C-Elegans/CounterDSP/README.org

* uFluidics Counter Project
This repository is the code for the EE4400 uFluidics Counting Project,
for the dsPIC33fj128gp802. To build, make sure MPLAB X and XC16 are
installed, then run 'make'.

** Circuit
   - Chip: dsPIC33fj128gp802 - dip variant
   - ADC connection
     - Pin AN9, package pin 28
   - SPI:
     - SCK: RP12, pin 23
     - MOSI: RP11, pin 22
     - MISO: RP13, pin 24
     - SS_N: RP14, pin 25
   - Passives:
     - 100nF caps: pin 28, pin 20, pin 13
     - 10uF cap: pin 20
       - *This component is REQUIRED to program the chip*
     - 1k pullup on MCLR_N (pin 1)
   - Supply Voltage
     - 3.25V

** Specifications
   - Analog input signal 200mv pk, unknown waveform
   - Amplified to some level 700mv pk?
   - Sampled at 10kHz
   - Cells counted somehow

# ** DONE List [100%]
#    CLOSED: [2018-03-24 Sat 14:36]
#    - [X] Test the features of the chip [100%]
#      - [X] ADC
#      - [X] UART
#      - [X] SPI
#      - [X] DMA [2/2]
#        - [X] UART
#        - [X] ADC
#      - [X] 80MHz Clock
#      - [X] 10kHz timer
#    - [X] Create A mini oscilloscope
#    - [X] Collect simulated waveform
#      - Waveforms are in data/
#    - [X] Analyze simulated data in matlab, determine best counting method
#      - [X] FFT amplitude
#      - [X] Correlation + threshold
#        - [X] Correlation
#        - [X] Create better correlation waveform. Currently just a sine wave, but
# 	     needs to approximate the triangle-y shape of the actual signal
#        - [X] Proper threshold amount
#    - [X] Program above solution on dsp
#      - Collect 256 samples from ADC
#      - Append them to previous 256 samples
#      - Convert samples to complex, pad with 0s to go to 1024 samples
#      - Run FFT
#      - multiply with FFT of the target waveform (stored in program memory)
#      - run IFFT
#      - Threshold + count
     
** Version 0.2 TODO [0%]
   - [ ] Add display [0%]
     - [ ] Choose display
     - [ ] Find/Write library
     - [ ] Write display routine
   - [ ] Increase number of channels
     - Goal of 3
   - [ ] Reduce memory usage per channel [0%]
     - [ ] Eliminate ping pong buffer
     - [ ] Copy unused data to X memory
     - [ ] Reduce sample storage [0/3]
       - [ ] Do unbatched correlation + threshold
       - [ ] Reduce size of buffers
       - [ ] Reduce sample rate
   - [ ] Design PCB

** Collected data
#+attr_html: :width 500px
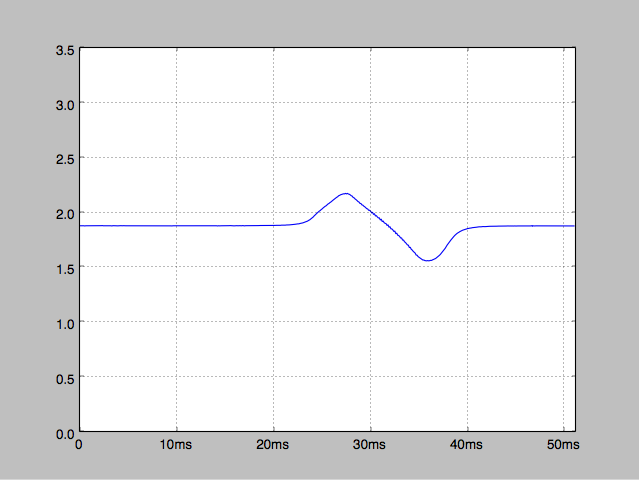
[picture p1: data/data2.png]


A large nail dropped through a straw, sampled at 5kHz
#+attr_html: :width 500px
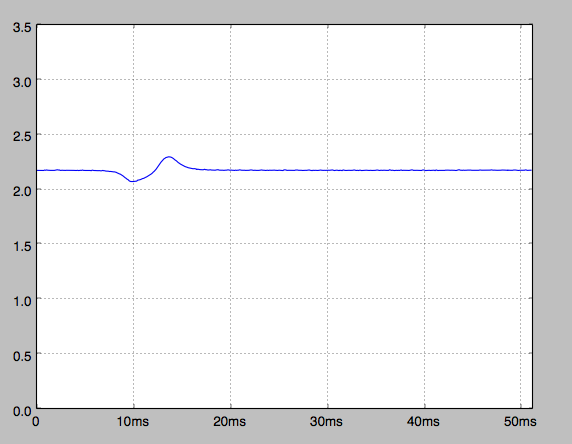
[picture p2: data/data4.png]


A small piece of nail dropped through a straw, 5kHz

* Characterization
** With Two cubic magnets
   - 58mV output from coil
   - 30 turns around straw
   - Straw
     - 5.3mm diameter
     - 
   - ??T field strength
     - Can calculate
     - Measure with hall effect sensor

* Amplifier
** Specifications
   - needs gain of 400mV/600nV=660,000
   - Uses AD8428 as low noise input amplifier (g=2000)
   - Uses ADa4528 as final amplifier
     - Feedback resistors set for g=330, Rf=33k, Rg=100\Omega
   - +- 5V power supply
     - May need to do some scaling with a third amp to feed to DSP
** Simulation
   - Outputs 300mV pk/pk for 300nVpk/pk input
   - 1/f Noise at 50mV
#+attr_html: :width 500px
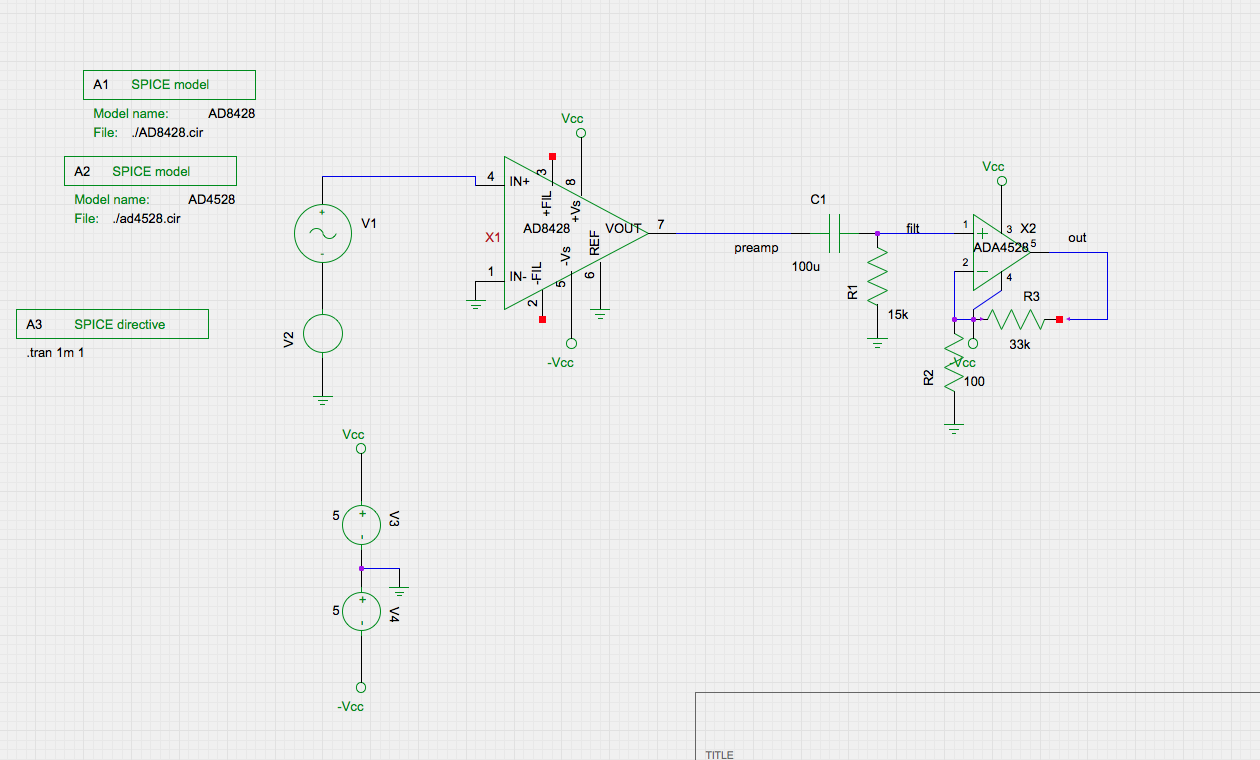
[picture p3: photos/schematic.png]

#+attr_html: :width 500px
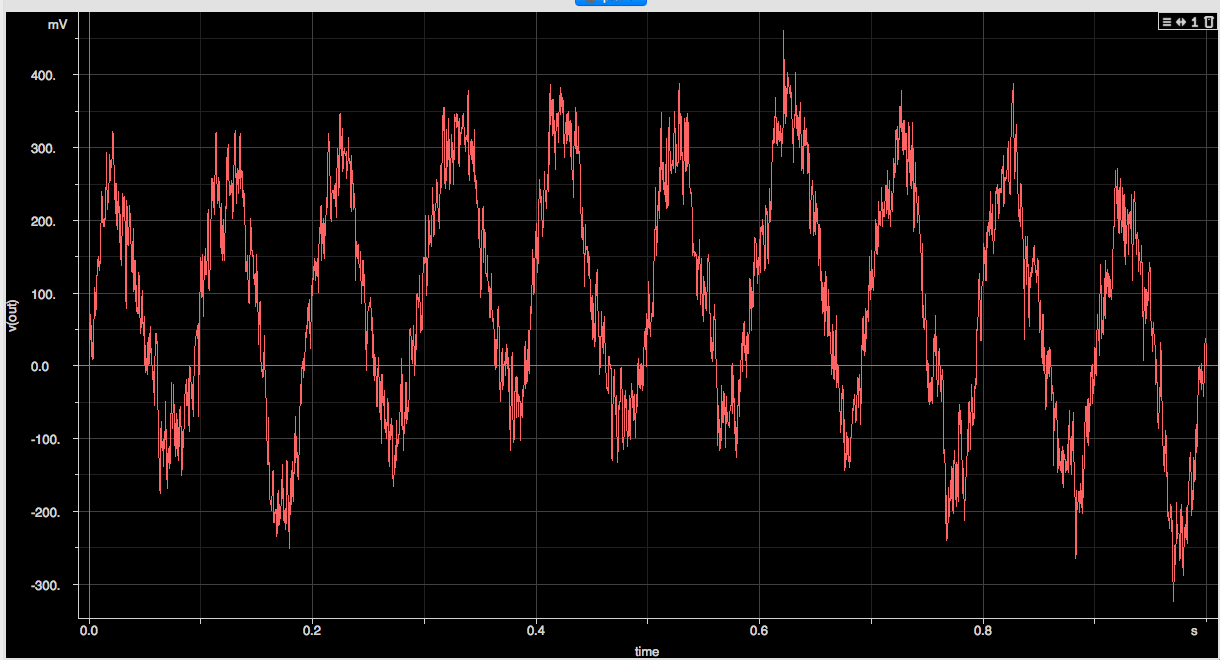
[picture p4: photos/amp1.png]
