C-Elegans/CounterDSP/circuit/schematic.png

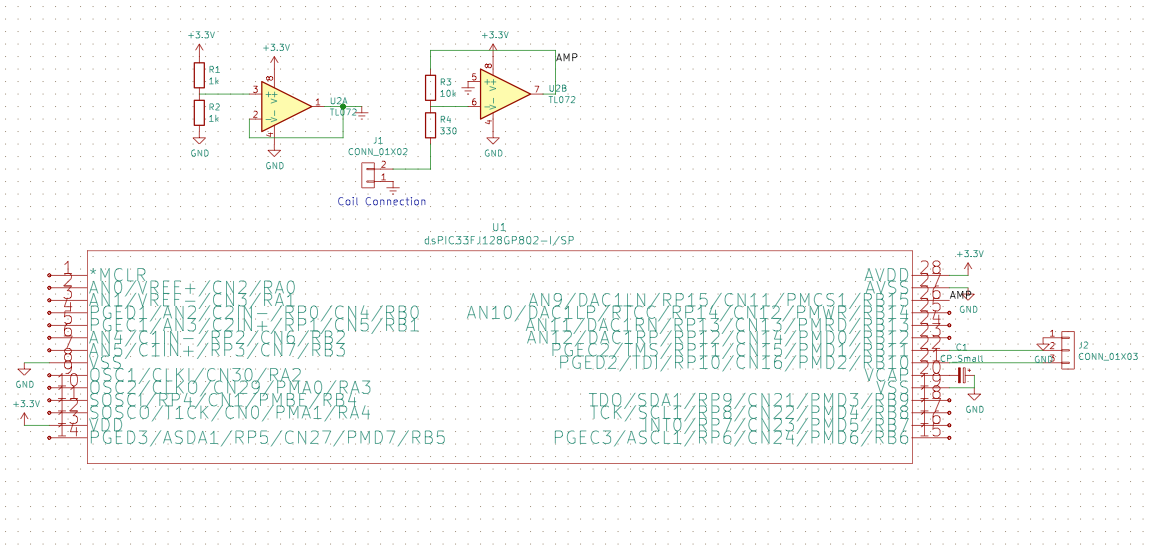
circuit/schematic.png
