C-Elegans/CounterDSP/data/data1.png

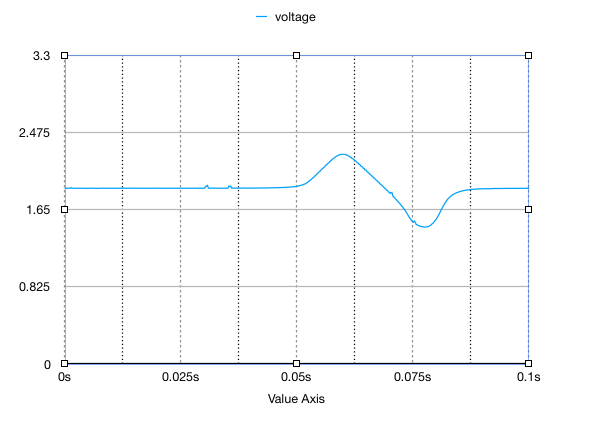
data/data1.png
