C-Elegans/CounterDSP/photos/ampv2_noise.png

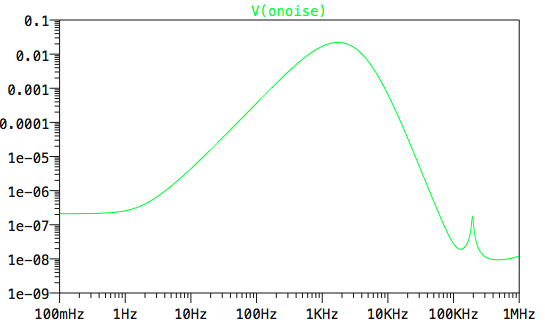
photos/ampv2_noise.png
