C-Elegans/CounterDSP/photos/ampv2_signal.png

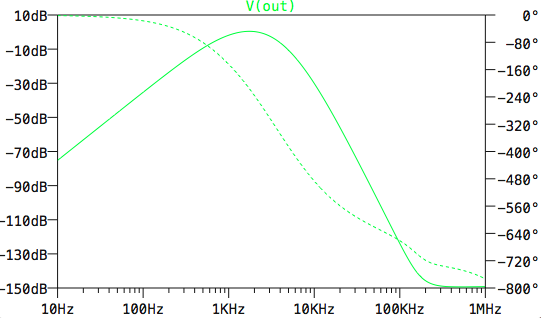
photos/ampv2_signal.png
