C-Elegans/CounterDSP/newamp/sim/ampv2.asc

C1: cap; 100n
C2: cap; 5n
C3: cap; 100n
C4: cap; 5n
C5: cap; 31n
C6: cap; 31n
C7: cap; 500n
C8: cap; 31n
L1: ind; 150n
R1: res; 10k
R2: res; 100
R3: res; 100
R4: res; 100
R5: res; 2k
R6: res; 15k
R7: res; 1k
R8: res; 1k
R9: res; 100
R10: res; 1k
R11: res; 100
R12: res; 1k
R13: res; 100
R14: res; 1k
R15: res; 1k
R16: res; 2k
U1: AD8428
U2: AD8428
U3: ADA4528
U4: ADA4528
U5: ADA4528
U6: ADA4528
U7: ADA4528
V1: voltage; 4
V2: voltage; 4
V3: voltage; SINE(0 100n 3k); AC 100n
Named nets: v-, v+, 0, in+, in-, fil+, fil-, pre, a, b, vref, out
;.tran 10u 5m
;.ac oct 50 10 1Meg
.noise v(out) v3 oct 100 0.1 1Meg
;.op
.temp -70
