C-Elegans/CounterDSP/newamp/sim/Draft1.asc

C3: cap; 100n
C4: cap; 1n
R5: res; 1.5k
R6: res; 15k
R7: res; 1k
R8: res; 1k
R9: res; 100
R10: res; 100k
U1: AD8428
U2: AD8428
U3: ADA4528
U4: ADA4528
V1: voltage; 4
V2: voltage; 4
V3: voltage; SINE(0 100n 3k); AC 100n
Named nets: v-, v+, 0, in+, in-, fil+, fil-, pre, vref, out
.ac oct 10 10 1Meg
