C-Elegans/CounterDSP/newamp/nVamp.kicad_pcb

## KiCad design newamp/nVamp.kicad_pcb (2018-12-07)

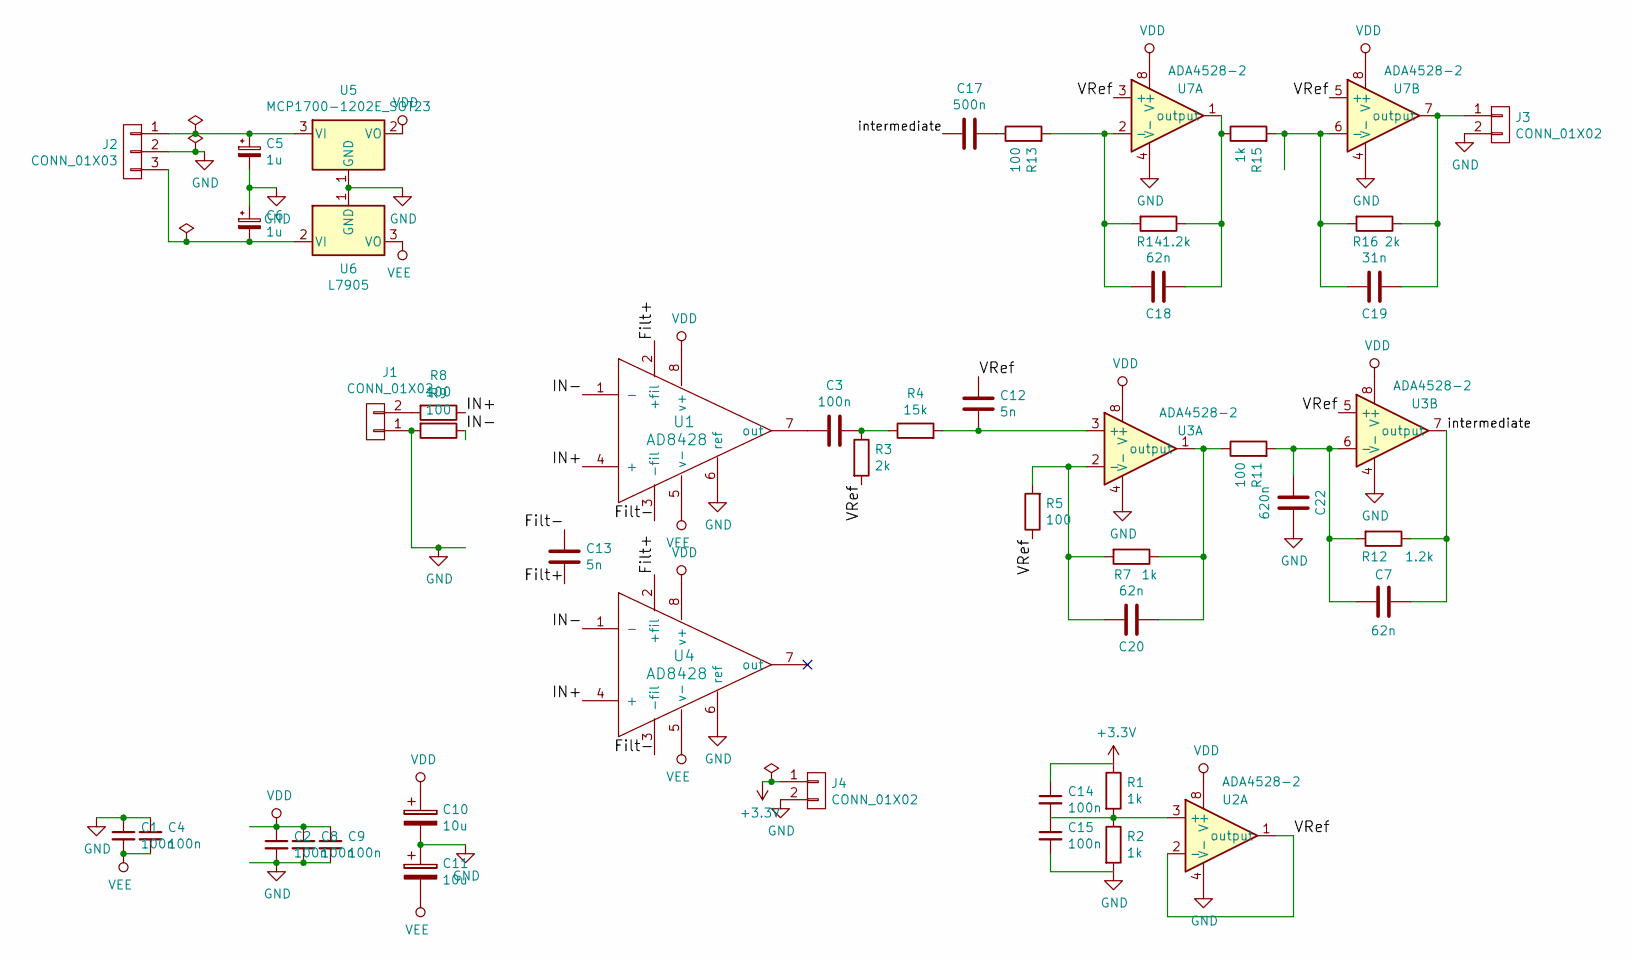
[picture p20: schematic nVamp.sch]

Parts:
C1, C2, C3, C4, C8, C9, C14, C15: 100n; C_0603_HandSoldering
C5, C6: 1u; CP_Radial_D5.0mm_P2.50mm
C7, C18, C20: 62n; C_0603_HandSoldering
C10, C11: 10u; CP_Radial_D5.0mm_P2.50mm
C12, C13: 5n; C_0603_HandSoldering
C17: 500n; C_0603_HandSoldering
C19: 31n; C_0603_HandSoldering
C22: 620n; C_0603_HandSoldering
J1, J3, J4: CONN_01X02; Pin_Header_Straight_1x02_Pitch2.54mm
J2: CONN_01X03; Pin_Header_Straight_1x03_Pitch2.54mm
R1, R2, R7, R15: 1k; R_0603_HandSoldering
R3, R16: 2k; R_0603_HandSoldering
R4: 15k; R_0603_HandSoldering
R5, R8, R9, R11, R13: 100; R_0603_HandSoldering
R12, R14: 1.2k; R_0603_HandSoldering
U1, U4: AD8428; SOIC-8_3.9x4.9mm_Pitch1.27mm
U2, U3, U7: ADA4528-2; MSOP-8_3x3mm_Pitch0.65mm
U5: MCP1700-1202E_SOT23; SOT-23
U6: L7905; SOT-89-3

Connections:
+3V3: C14.1, J4.1, R1.1
/Filt+: C13.2, U1.2 (+fil), U4.2 (+fil)
/Filt-: C13.1, U1.3 (-fil), U4.3 (-fil)
/IN+: R8.1, U1.4 (+), U4.4 (+)
/IN-: R9.1, U1.1 (-), U4.1 (-)
/VRef: C12.1, R3.2, R5.1, U2.1 (output), U2.2 (-), U3.5 (+), U7.3 (+), U7.5 (+)
/intermediate: C7.1, C17.2, R12.1, U3.7 (output)
GND: C1.1, C2.2, C4.1, C5.2, C6.1, C8.2, C9.2, C10.2, C11.1, C15.2, C22.1, J1.1, J2.2, J3.2, J4.2, R2.2, R9.2, U1.6 (ref), U2.4 (V-), U3.4 (V-), U4.6 (ref), U5.1 (GND), U6.1 (GND), U7.4 (V-)
unnamed: C3.1, R3.1, R4.1
unnamed: C3.2, U1.7 (out)
unnamed: C5.1, J2.1, U5.3 (VI)
unnamed: C6.2, J2.3, U6.2 (VI)
unnamed: C12.2, R4.2, U3.3 (+)
unnamed: C14.2, C15.1, R1.2, R2.1, U2.3 (+)
unnamed: C17.1, R13.1
unnamed: C18.1, R14.1, R15.1, U7.1 (output)
unnamed: C18.2, R13.2, R14.2, U7.2 (-)
unnamed: C19.1, J3.1, R16.1, U7.7 (output)
unnamed: C19.2, R15.2, R16.2, U7.6 (-)
unnamed: C20.1, R7.1, R11.1, U3.1 (output)
unnamed: C20.2, R5.2, R7.2, U3.2 (-)
unnamed: C7.2, C22.2, R11.2, R12.2, U3.6 (-)
unnamed: J1.2, R8.2
VDD: C2.1, C8.1, C9.1, C10.1, U1.8 (v+), U2.8 (V+), U3.8 (V+), U4.8 (v+), U5.2 (VO), U7.8 (V+)
VEE: C1.2, C4.2, C11.2, U1.5 (v-), U4.5 (v-), U6.3 (VO)

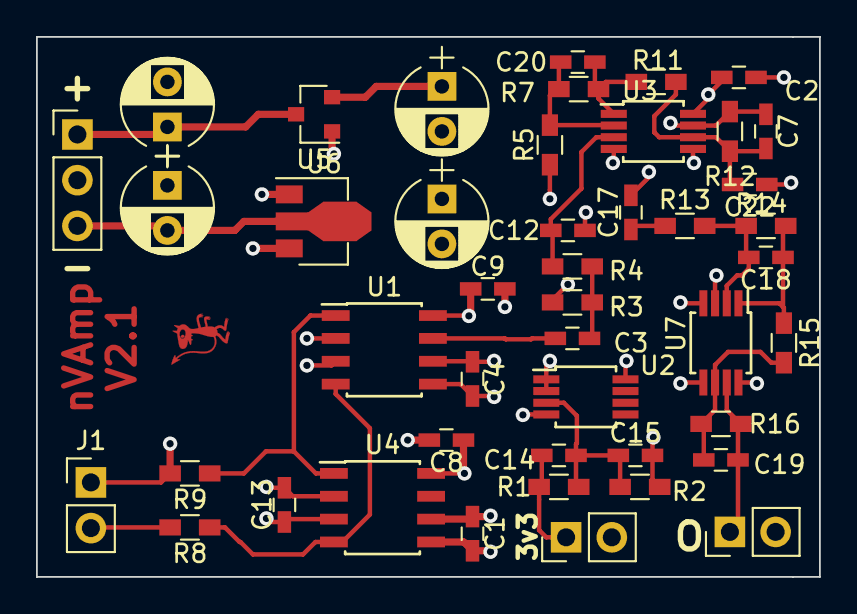
[picture p21: board nVamp.kicad_pcb from above]

Board: 4 copper layers, 43.5 x 30.0 mm, 45 parts (0 on the bottom side), 25 nets.
