C-Elegans/CounterDSP/newamp/nVamp_v1.0.kicad_pcb

## KiCad design newamp/nVamp_v1.0.kicad_pcb (2018-03-24, an earlier design)

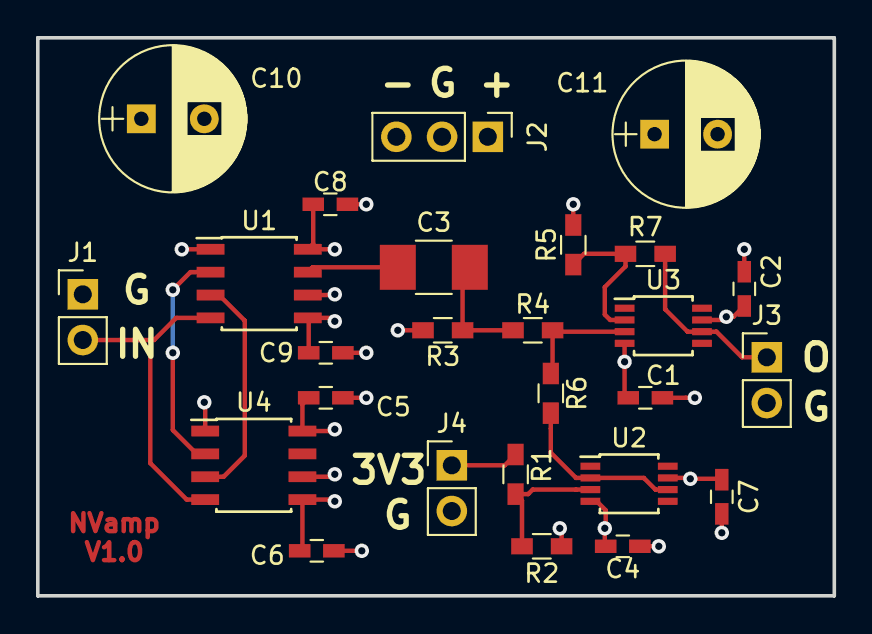
[picture p22: board nVamp_v1.0.kicad_pcb from above]

Board: 4 copper layers, 44.2 x 31.0 mm, 26 parts (0 on the bottom side), 14 nets.

Parts:
C1, C2, C4, C5, C6, C7, C8, C9: 100n; C_0603_HandSoldering
C3: 100u; C_1210_HandSoldering
C10, C11: CP; CP_Radial_D8.0mm_P3.50mm
J1, J3, J4: CONN_01X02; Pin_Header_Straight_1x02_Pitch2.54mm
J2: CONN_01X03; Pin_Header_Straight_1x03_Pitch2.54mm
R1, R2: 1k; R_0603_HandSoldering
R3: 15k; R_0603_HandSoldering
R4, R5: 100; R_0603_HandSoldering
R6, R7: 33k; R_0603_HandSoldering
U1, U4: AD8428; SOIC-8_3.9x4.9mm_Pitch1.27mm
U2, U3: ADA4528; TSSOP-8_3x3mm_Pitch0.65mm

Connections:
+3V3: J4.1, R1.1
/Filt+: U1.2, U4.2
/Filt-: U1.3, U4.3
/IN+: J1.2, U1.4, U4.4
/VRef: R6.2, U2.2, U2.6
GND: C1.1, C2.2, C4.1, C5.1, C6.1, C7.2, C8.2, C9.2, C10.2, C11.1, J1.1, J2.2, J3.2, J4.2, R2.2, R3.2, R5.1, U1.1, U1.6, U4.1, U4.6
unnamed: C3.1, R3.1, R4.1
unnamed: C3.2, U1.7
unnamed: J3.1, R7.1, U3.6
unnamed: R1.2, R2.1, U2.3
unnamed: R4.2, R6.1, U3.3
unnamed: R5.2, R7.2, U3.2
VDD: C2.1, C7.1, C8.1, C9.1, C10.1, J2.1, U1.8, U2.7, U3.7, U4.8
VEE: C1.2, C4.2, C5.2, C6.2, C11.2, J2.3, U1.5, U2.4, U3.4, U4.5
