C-Elegans/CounterDSP/src/twid.c

#include <dsp.h>
const fractcomplex twiddleFactors[]
__attribute__ ((space(auto_psv), aligned (1024*2)))= {
0x7fff, 0x0000, 0x7fff, 0xff37, 0x7ffe, 0xfe6e, 0x7ffa, 0xfda5, 
0x7ff6, 0xfcdc, 0x7ff1, 0xfc13, 0x7fea, 0xfb4a, 0x7fe2, 0xfa81, 
0x7fd9, 0xf9b8, 0x7fce, 0xf8ef, 0x7fc2, 0xf827, 0x7fb5, 0xf75e, 
0x7fa7, 0xf695, 0x7f98, 0xf5cd, 0x7f87, 0xf505, 0x7f75, 0xf43c, 
0x7f62, 0xf374, 0x7f4e, 0xf2ac, 0x7f38, 0xf1e4, 0x7f22, 0xf11c, 
0x7f0a, 0xf055, 0x7ef0, 0xef8d, 0x7ed6, 0xeec6, 0x7eba, 0xedff, 
0x7e9d, 0xed38, 0x7e7f, 0xec71, 0x7e60, 0xebab, 0x7e3f, 0xeae4, 
0x7e1e, 0xea1e, 0x7dfb, 0xe958, 0x7dd6, 0xe892, 0x7db1, 0xe7cd, 
0x7d8a, 0xe707, 0x7d63, 0xe642, 0x7d3a, 0xe57d, 0x7d0f, 0xe4b9, 
0x7ce4, 0xe3f4, 0x7cb7, 0xe330, 0x7c89, 0xe26d, 0x7c5a, 0xe1a9, 
0x7c2a, 0xe0e6, 0x7bf9, 0xe023, 0x7bc6, 0xdf61, 0x7b92, 0xde9e, 
0x7b5d, 0xdddc, 0x7b27, 0xdd1b, 0x7aef, 0xdc59, 0x7ab7, 0xdb99, 
0x7a7d, 0xdad8, 0x7a42, 0xda18, 0x7a06, 0xd958, 0x79c9, 0xd898, 
0x798a, 0xd7d9, 0x794a, 0xd71b, 0x790a, 0xd65c, 0x78c8, 0xd59e, 
0x7885, 0xd4e1, 0x7840, 0xd424, 0x77fb, 0xd367, 0x77b4, 0xd2ab, 
0x776c, 0xd1ef, 0x7723, 0xd134, 0x76d9, 0xd079, 0x768e, 0xcfbe, 
0x7642, 0xcf04, 0x75f4, 0xce4b, 0x75a6, 0xcd92, 0x7556, 0xccd9, 
0x7505, 0xcc21, 0x74b3, 0xcb69, 0x7460, 0xcab2, 0x740b, 0xc9fc, 
0x73b6, 0xc946, 0x735f, 0xc890, 0x7308, 0xc7db, 0x72af, 0xc727, 
0x7255, 0xc673, 0x71fa, 0xc5c0, 0x719e, 0xc50d, 0x7141, 0xc45b, 
0x70e3, 0xc3a9, 0x7083, 0xc2f8, 0x7023, 0xc248, 0x6fc2, 0xc198, 
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
0x5134, 0x62f2, 0x5098, 0x6371, 0x4ffb, 0x63ef, 0x4f5e, 0x646c, 
0x4ec0, 0x64e9, 0x4e21, 0x6564, 0x4d81, 0x65de, 0x4ce1, 0x6657, 
0x4c40, 0x66d0, 0x4b9e, 0x6747, 0x4afb, 0x67bd, 0x4a58, 0x6832, 
0x49b4, 0x68a7, 0x490f, 0x691a, 0x486a, 0x698c, 0x47c4, 0x69fd, 
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
};
