C-Elegans/CounterDSP/src/sig.c

#include <dsp.h>
const int siglen = 60;
fractional sig[] __attribute__((space(xmemory))) = {
0x0000,
0x0031,
0x005f,
0x008c,
0x00b5,
0x00dc,
0x0104,
0x012d,
0x015a,
0x018c,
0x01c0,
0x01f4,
0x0223,
0x024a,
0x0263,
0x026c,
0x0263,
0x024a,
0x0223,
0x01f4,
0x01c0,
0x018c,
0x015a,
0x012d,
0x0104,
0x00dc,
0x00b5,
0x008c,
0x005f,
0x0031,
0x0000,
0xffcf,
0xffa1,
0xff74,
0xff4b,
0xff24,
0xfefc,
0xfed3,
0xfea6,
0xfe74,
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
};
