C-Elegans/CounterDSP/(commit log)

2017-12-28 Use the MPLib UART functions for printing
2018-01-11 setup ADC to work with DMA
2018-01-11 Set DMA to ping pong mode, fix indentation for emacs
    [main.c]
2018-01-12 Get Chip working + UART
2018-01-12 Test adc
2018-01-13 Get SPI working (though very simply)
2018-01-13 80MHz clock working
    Had some difficulties with programming, turns out a 10uF cap to Vcap
    is required for correct operation.
    [config.h, main.c]
2018-01-13 Get uart working at 1Mbaud
2018-01-13 ADC DMA transfers working
2018-01-14 Configure ADC to sample off Timer3
    Now ADC samples at 10kHz and the buffer of samples gets sent to the
    host computer over 1Mbaud uart
2018-01-14 Collect some sample waveforms
2018-01-14 Add data from smaller magnets, begin data analysis
2018-01-16 Collect data with two magnets dropped
2018-01-22 Add schematic of measurement circuit
    [CounterDSP.kicad_pcb, CounterDSP.sch]
2018-01-23 Begin PCB design
    [nVamp.kicad_pcb, nVamp.sch]
2018-01-24 Add simulation of AD8248
    [amp.sch]
2018-01-24 Test DC blocking high pass filter
    [amp.sch]
2018-01-24 Simulate full amplifier
    100nV 10Hz signal ->
    AD8428 instrumentation amplifier ->
    RC high pass filter with fc=0.1Hz ->
    AD4528 op amp with gain 1000 ->
    200mV 10Hz signal
    [amp.sch]
2018-01-24 Update PCB to use AD8428 and AD4528 amps
    [nVamp.kicad_pcb, nVamp.sch]
2018-01-24 Add transient noise source
    Approximate the noise from the first amplifier stage
    [amp.sch]
2018-01-24 Add schematic image to README
    [amp.sch]
2018-01-30 Pretty up schematics
    [CounterDSP.sch, nVamp.sch]
2018-01-30 Do not scale fft output for uart
2018-01-30 Fix errors in last commit
    [main.c, periph.h]
2018-01-31 Try to view waveform with overlapped samples
2018-02-05 Modify schematic so it looks nicer
    [CounterDSP.sch]
2018-02-12 Update PCB to use two AD8428s for lower noise
    [nVamp.kicad_pcb, nVamp.sch]
2018-02-14 Make a better, 4 layer design for nVamp
    [_saved_nVamp.sch, nVamp.kicad_pcb, nVamp_2layer.kicad_pcb]
2018-03-24 Update amplifier
    [_saved_nVamp.sch, nVamp.kicad_pcb, nVamp.sch]
2018-03-29 Update spice schematic
    [amp.sch]
2018-04-11 Add noise analysis & data
    [amp.sch]
2018-04-23 Update schematics to add filters and AD4528 single supply
    [amp.sch, nVamp.sch]
2018-05-03 Add differential input to simulation
    [amp.sch]
2018-05-04 Redo amplifier schematic in ltspice Add some pictures of the output New amplifier has a lot more filtering, as well as a differential input
2018-05-04 Begin working on v2 pcb
    [nVamp.kicad_pcb, nVamp.sch, nVamp_v1.0.kicad_pcb]
2018-09-18 Finished version 2.0 of the amplifier PCB
    Add better filtering from Ben,
    Add differential input
    [nVamp.kicad_pcb, nVamp.sch]
2018-12-07 Lots of changes
    [amp.sch, nVamp-2018-08-14-15-25-14.sch, nVamp-2018-10-02-15-56-30.sch, nVamp.kicad_pcb, nVamp.sch]
